mjholtkamp/shofanduino/design/shofanduino_bb.png

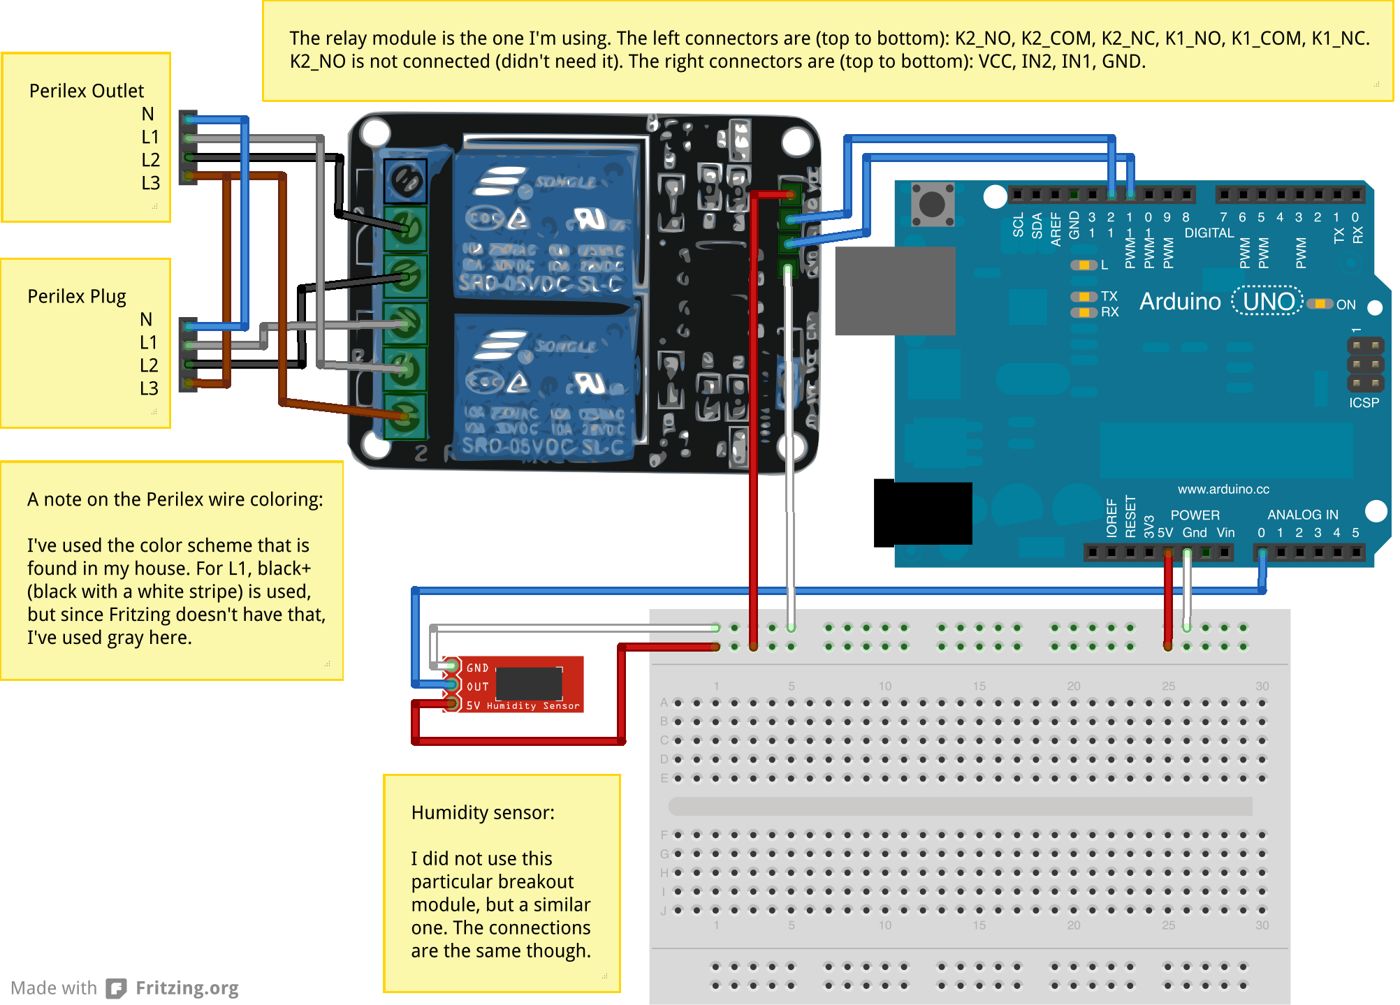
design/shofanduino_bb.png
