mjholtkamp/shofanduino/plots/humidity-day.png

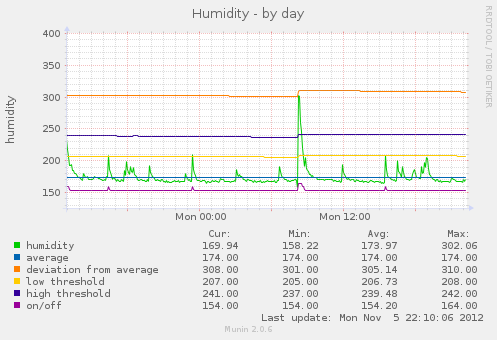
plots/humidity-day.png
