mjholtkamp/shofanduino/plots/humidity-week.png

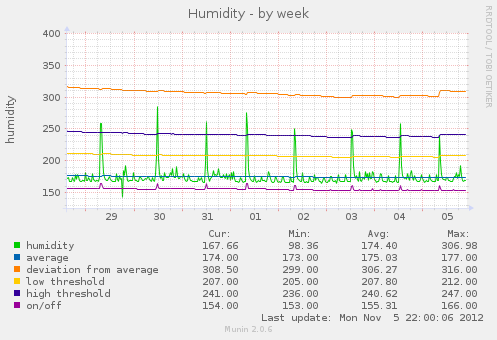
plots/humidity-week.png
