mjholtkamp/shofanduino/(commit log)

2012-06-16 Added simple sketch based on decay, changed generator to take into account settling (initial drifting) of humidity sensor
2012-07-03 Version that actually switches the relays
2012-07-03 More changes after Real World experiments
    * Change humidity variation period to a week instead of a year
    (I saw it change like that in the real world)
    * Increase the decay to cope with that shorter period.
    * Do not yield every sample, but only every 5 minutes, this makes
    plotting a bit faster (and at that scale, you won't see it anyway)
2012-07-03 Changed decay in arduino project accordingly
2012-09-11 Don't print all data points, limit them to 2000 or so, so handling them in gnuplot doesn't take a lot of memory
2012-09-22 Lower the low and high thresholds, so the fan kicks in earlier and stops later
2012-11-16 Reverted back to old deviation calculation
    Noticed some spikes during high humidity that
    caused the deviation to go to jump and stay high,
    even though the spikes were really short. After
    such a spike, the high threshold was basically
    never reached, so the fan wasn't turned on
    anymore.
    The older method that was used before handles
    these spikes better, by increasing the deviation
    gradually (multiple spikes will increase the
    deviation more) instead of instantly. This makes
    sure that incidental spikes do not instantly
    increase the deviation (and indirectly the high
    threshold) to values that are way too high.
    The deviation changes faster now (0.01 instead of
    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
    [generate_humidity_data.py, shofanduino.ino]
2013-01-30 Added small test program to see if we can use the half-life formula to calculate a decay on the arduino (and if the difference in the results don't differ too much)
    [param_research.ino]
2013-01-30 Added shofanduino2 program, much simpler since some of the calculations are now done in the sensor (filtering out noisy values).
    Instead of 'avg' and 'max', we use envelope min
    and max values that try to hug the humidity with
    a slow moving function. The slow moving function
    is based on the half-life equation, so the
    parameters are more intuitive.
2013-01-31 Don't switch the relays constantly, only when changing states.
    The previous code did this correctly, but due to
    code simplifications this was removed as well. Not
    a big problem, but it's nicer not to switch
    constantly.
    [shofanduino2.ino]
2013-01-31 Added a minimum difference between the extrema, so the shofanduino doesn't turn on the fan when it is connected for the first time, or when it is reset.
    This also needs a cap for the maximum, otherwise
    it will go above the maximum value that the sensor
    will give back!
    [shofanduino2.ino]
2013-02-03 Don't switch to the old state, switch to the new state.
2013-02-03 New pins on the Teensy2
    These pins are more convenient for soldering on
    the Teensy2.
2013-10-19 Clamp humidity values. Make envelope_min halflife shorter
    [shofanduino2.ino]
2014-01-20 Added version that works for DHT11 sensor
    I tried to make the code so it can be made for DHT22 again as well.
2014-01-20 Use constants, use median filter
    Update the min/max envelope immediately, instead of going half the step. Going half was to mitigate the salt/pepper noise, but half can still be a huge step. Instead, solve it by a median filter (see RunningMedian library).
    Hopefully 3 values should be good enough:according to my data the value only goes up by half the difference (100 - current value) some times, never 3/4. This means that I haven't observed salt/pepper noise for 2 consecutive values. Of course this can still happen... If it does, this value (3) should be increased to 5.
    [shofanduino2_dht11.ino]
2014-11-01 Tweak variables to improve robustness and response time
    We now take the median of 5 samples, meaning that salt and pepper
    noise has to occur 3 out of 5 times to have an effect.
    Also, the highRatio is now set to 1/8th instead of 1/6th to make
    the fan turn on quicker.
    [shofanduino2_dht11.ino]
